niccolascassel/moradadasrosas/README.md

moradadasrosas
==============

Morada das Rosas allotment's projects
