niccolascassel/moradadasrosas/(list of files, cad)

Other CAD files:
Drawings/Morada das Rosas - Prancha 7.dwg
Drawings/Morada das Rosas - Prancha 1.dwg
Drawings/Morada das Rosas - Prancha 5.dwg
Drawings/CASA DE BOMBA.dwg
Drawings/Morada das Rosas - Prancha 3.dwg
Drawings/IMPLANTAÇÃO.dwg
Drawings/Morada das Rosas - Prancha 2.dwg
Drawings/Morada das Rosas - Prancha 4.dwg
Drawings/50m³ x 10m tamaca.dwg
Drawings/Morada das Rosas - Prancha 6.dwg
