niccolascassel/moradadasrosas/Documentation/ADUTORA.pdf

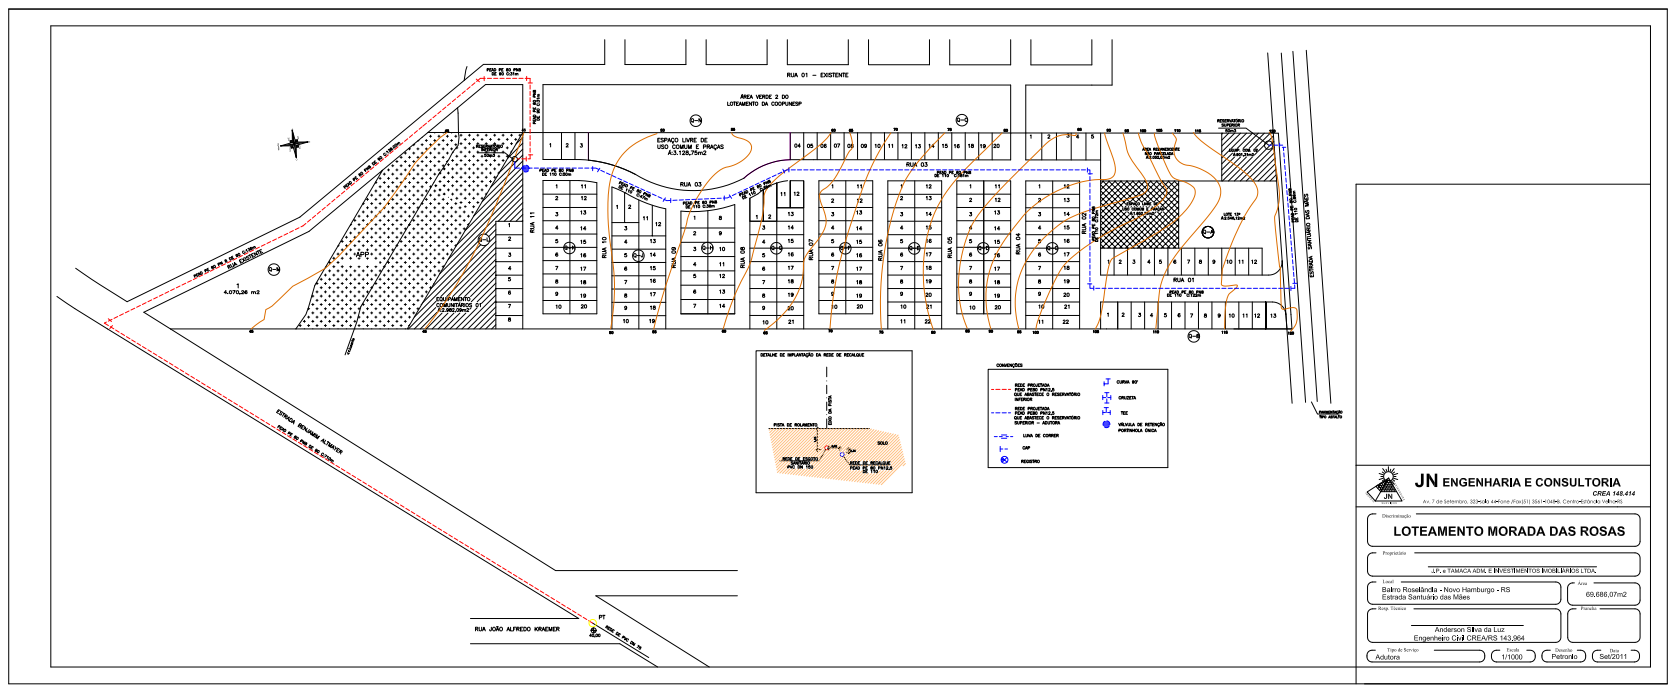
[picture p1: page 1]
