niccolascassel/moradadasrosas/Documentation/CASA DE BOMBA.pdf

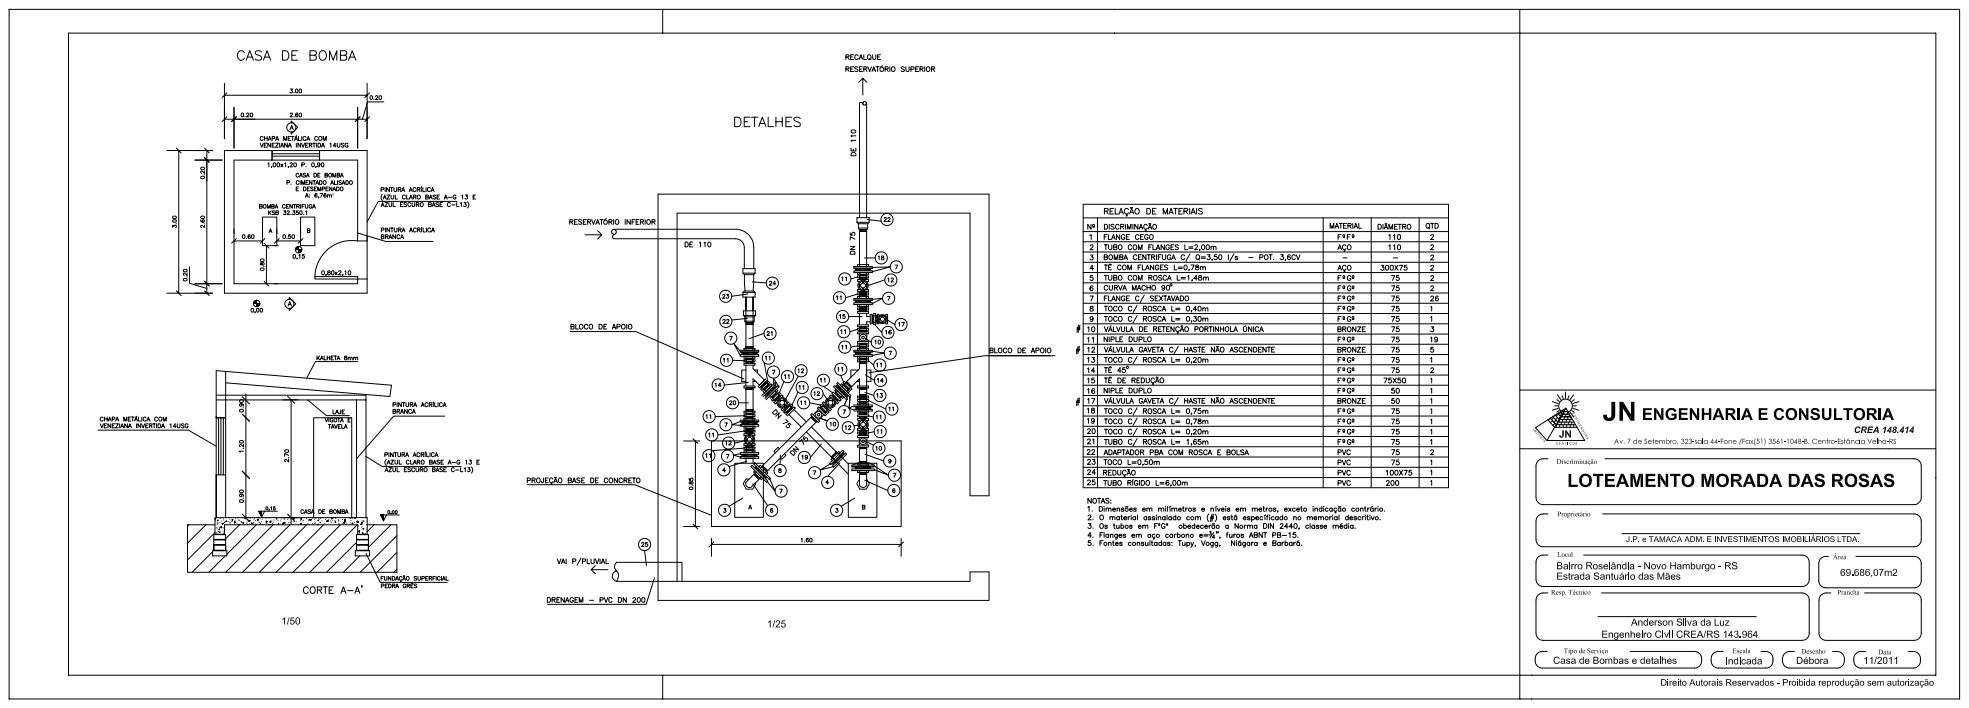
[picture p2: page 1]
